shimingliu318-svg/ES1-Camera-Slider/docs/wiring-diagram.png

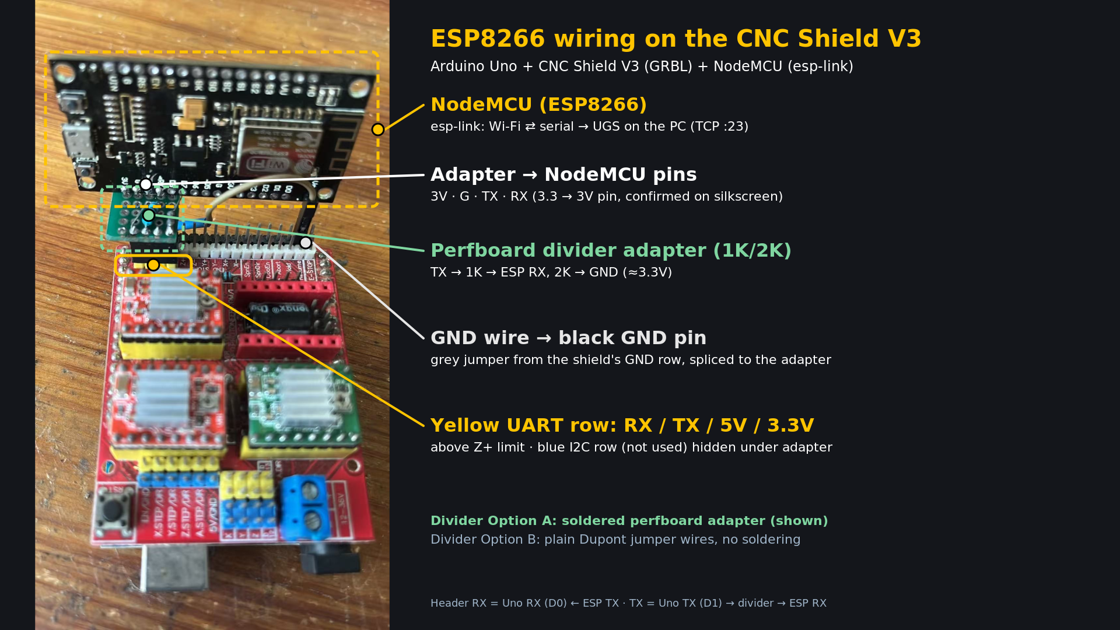
docs/wiring-diagram.png
