shimingliu318-svg/ES1-Camera-Slider/stl/转台底座.STL

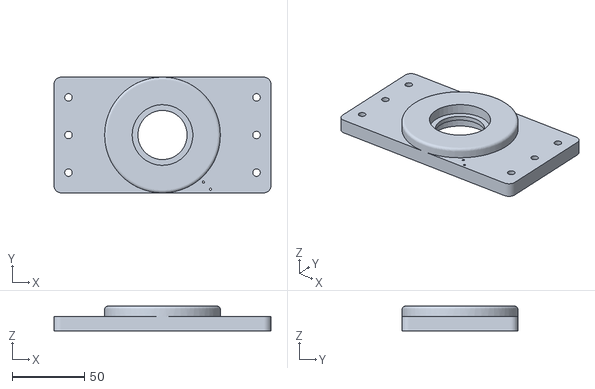
[picture p2: CAD file, 2026-10-20]
stl/转台底座.STL
150.0 x 80.0 x 17.0
