shimingliu318-svg/ES1-Camera-Slider/stl/滑车.STL

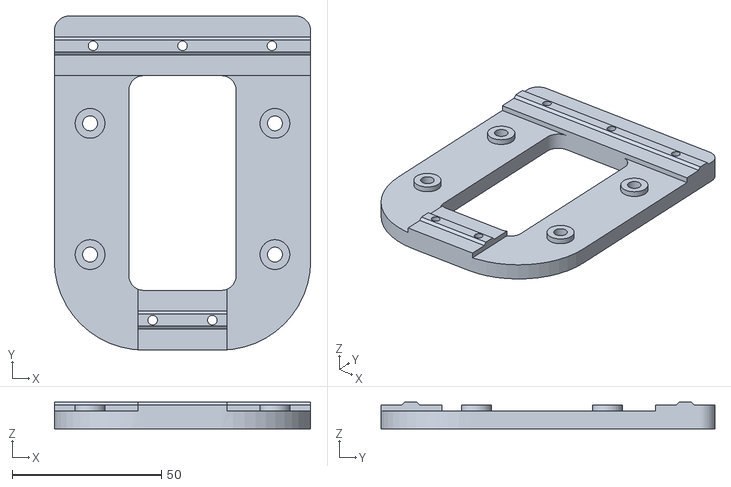
[picture p3: CAD file, 2026-10-20]
stl/滑车.STL
86.0 x 112.0 x 9.00
