shimingliu318-svg/ES1-Camera-Slider/stl/转台电机座.STL

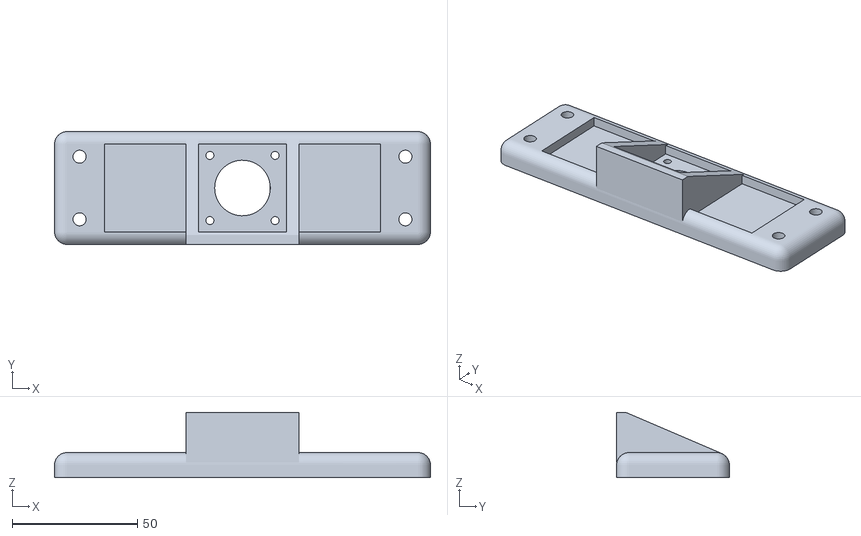
[picture p4: CAD file, 2026-10-20]
stl/转台电机座.STL
150.0 x 45.0 x 26.0
