shimingliu318-svg/ES1-Camera-Slider/stl/主板座.STL

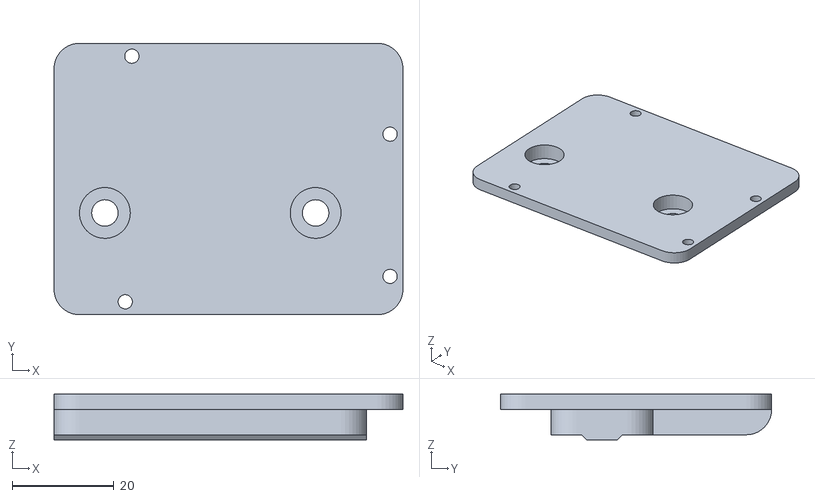
[picture p5: CAD file, 2026-10-20]
stl/主板座.STL
68.6 x 53.3 x 9.00
