shimingliu318-svg/ES1-Camera-Slider/stl/连接件.STL

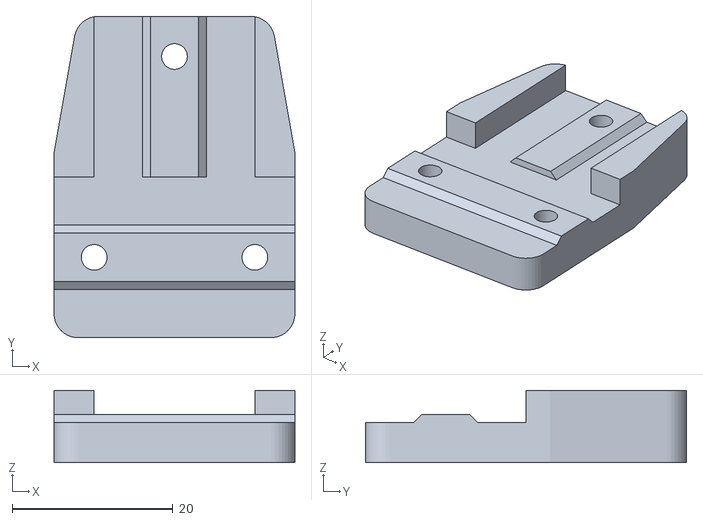
[picture p6: CAD file, 2026-10-20]
stl/连接件.STL
30.0 x 40.0 x 9.00
