shimingliu318-svg/ES1-Camera-Slider/stl/转台电机座（42步进）.STL

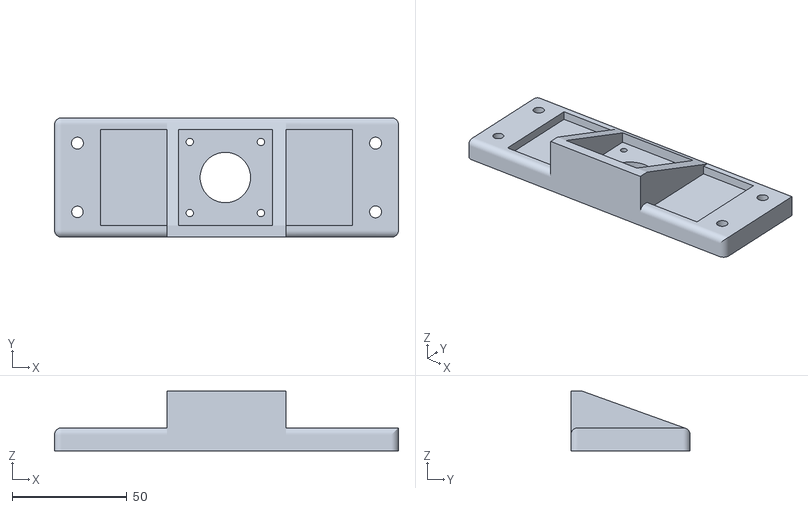
[picture p7: CAD file, 2026-10-20]
stl/转台电机座（42步进）.STL
150.0 x 52.0 x 26.0
