shimingliu318-svg/ES1-Camera-Slider/stl/X轴电机座.STL

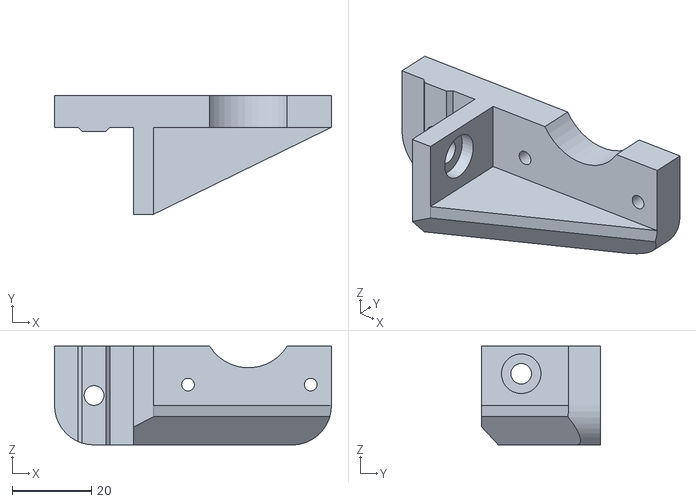
[picture p8: CAD file, 2026-10-20]
stl/X轴电机座.STL
70.0 x 30.0 x 25.0
