shimingliu318-svg/ES1-Camera-Slider/stl/皮带张紧座.STL

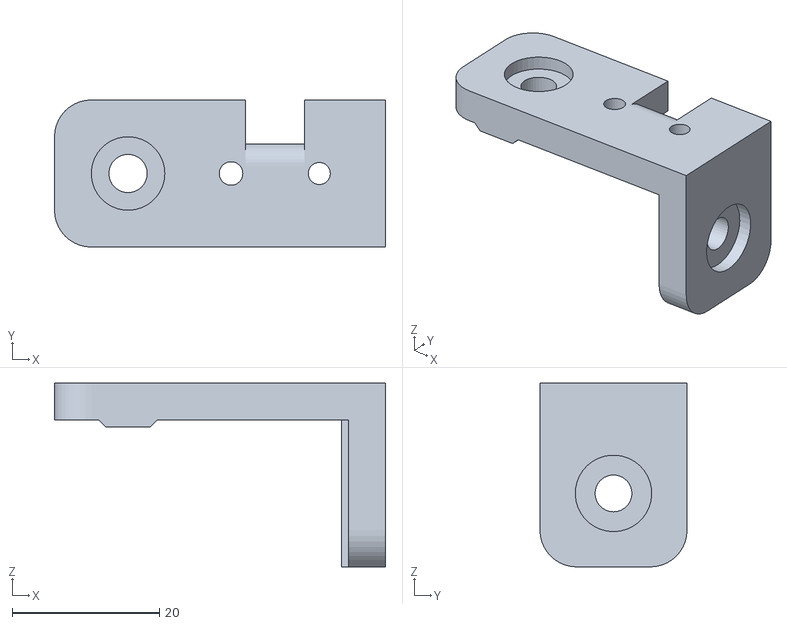
[picture p9: CAD file, 2026-10-20]
stl/皮带张紧座.STL
45.0 x 20.0 x 25.0
