shimingliu318-svg/ES1-Camera-Slider/stl/转台转轴上.STL

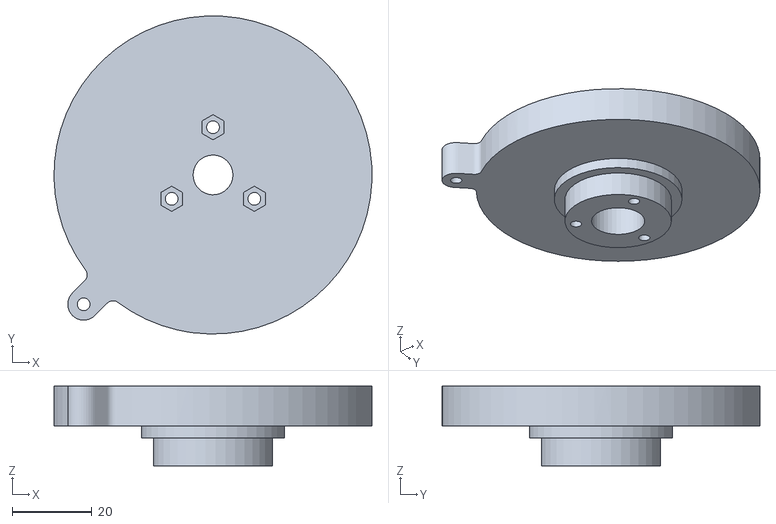
[picture p10: CAD file, 2026-10-20]
stl/转台转轴上.STL
80.0 x 80.0 x 20.0
