shimingliu318-svg/ES1-Camera-Slider/stl/端盖.STL

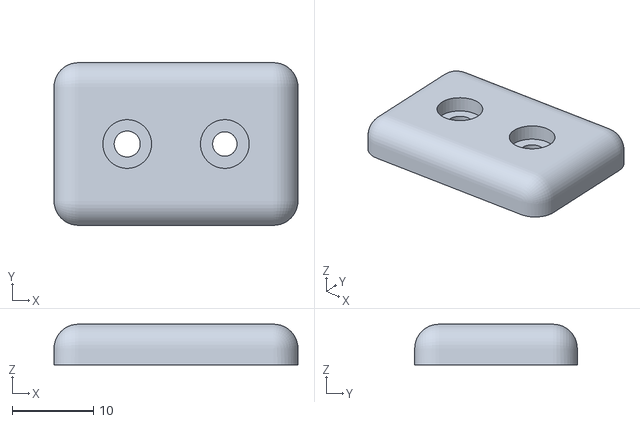
[picture p11: CAD file, 2026-10-20]
stl/端盖.STL
30.0 x 20.0 x 5.00
