shimingliu318-svg/ES1-Camera-Slider/stl/转台转轴下.STL

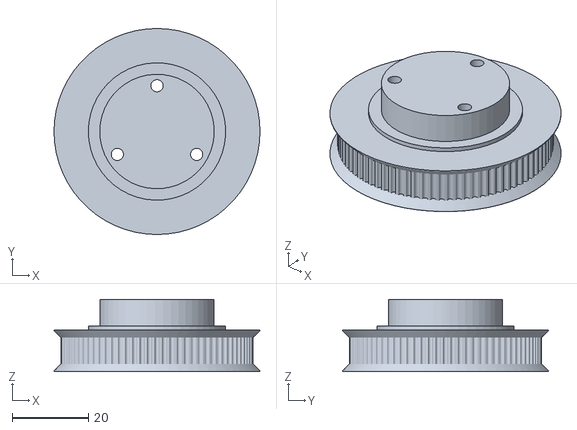
[picture p12: CAD file, 2026-10-20]
stl/转台转轴下.STL
54.0 x 54.0 x 19.0
