shimingliu318-svg/ES1-Camera-Slider/stl/滑轮.STL

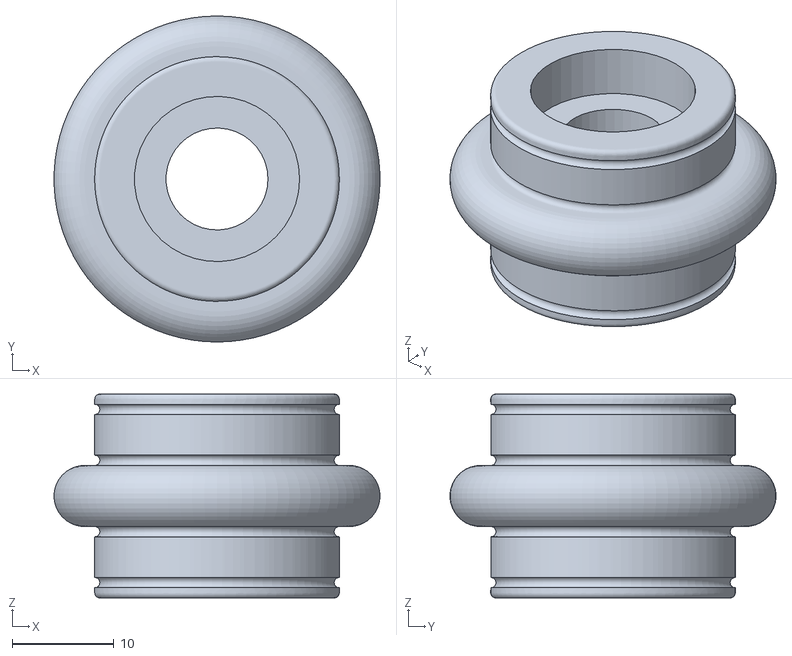
[picture p13: CAD file, 2026-10-20]
stl/滑轮.STL
32.0 x 32.0 x 20.0
