shimingliu318-svg/ES1-Camera-Slider/stl/限位座.STL

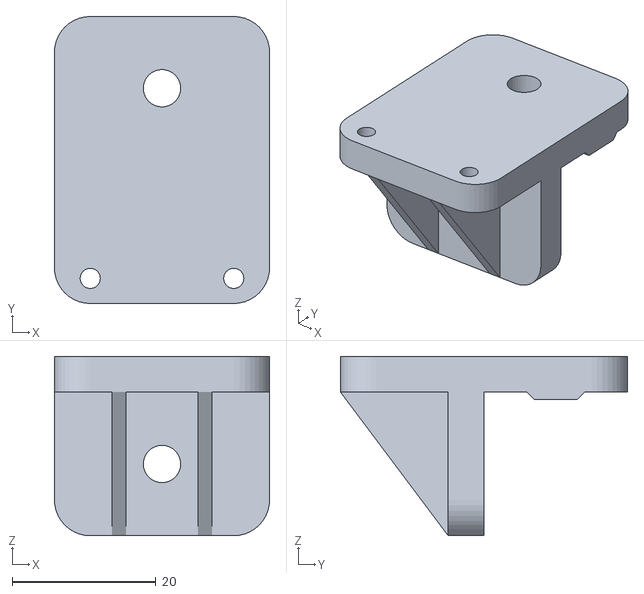
[picture p14: CAD file, 2026-10-20]
stl/限位座.STL
30.0 x 40.0 x 25.0
