shimingliu318-svg/ES1-Camera-Slider/(commit log)

2026-10-20 Add parts list and wiring diagram
2026-10-20 Add 13 printable STL parts
    [X轴电机座.STL, 主板座.STL, 滑车.STL, 滑轮.STL, 皮带张紧座.STL, 端盖.STL, 转台底座.STL, 转台电机座.STL]
2026-10-20 Add GRBL settings
